odenwilusenz/LRK/Programmieren/workspace/wireless_led_bar/lrkmaster.py

import serial
import time

B1mask = 0b00000001
B2mask = 0b00000010
G1mask = 0b00000100
G2mask = 0b00001000
R1mask = 0b00000010
R2mask = 0b00000100

b_calibration = [x**2/600 for x in range(0,256)]
g_calibration = [x**2/400 for x in range(0,256)]
r_calibration = [x**2/255 for x in range(0,256)]

class LRKError(Exception):
  pass

class LRKmaster:
  def __init__(self, portname):
    self.portname = portname
    self.lastaddress = (231,231)
    self.lastcolour = (0,0,0,0,0,0)
    return

  def __enter__(self):
    self.ser = serial.Serial(self.portname, 115200, serial.EIGHTBITS, serial.PARITY_NONE, serial.STOPBITS_ONE, 2, False, False, None, False, None)
    time.sleep(2)
    self.ser.flushInput()
    self.ser.flushOutput()
    try:
      self.hello()
      self.flushFifos()
      self.setRetry(3,15)
      self.address(231,231)
      self.colour(0,0,0,0,0,0)
    except:
      self.ser.close()
      raise
    return self

  def __exit__(self, et,ev,tb):
    if (et == None and ev == None and tb == None):
      self.ser.write(b'q')
      self.ser.write(b'a231,231,231,231,231.')
      self.ser.write(b'b0,0,0,0,0,0,0,0,0,0,0,0,0,0.')
      self.ser.flushInput()
    self.ser.close()
    return

  def hello(self):
    self.ser.write(b'h')
    hello = str.strip(self.ser.readline().decode())
    if (hello != '1.1ok'):
      raise LRKError('device identification failed. device returned ', hello, ' instead of 1.1ok')
    return

  def status(self):
    self.ser.write(b's')
    return str.strip(self.ser.readline().decode())

  def readReg(self, reg):
    self.ser.write(b'r')
    self.ser.write(str(int(reg) % 256).encode())
    self.ser.write(b'.')
    return str.strip(self.ser.readline().decode())

  def setRetry(self, interval, count):
    self.ser.write(b'm')
    self.ser.write(str(int(interval) % 16).encode())
    self.ser.write(b',')
    self.ser.write(str(int(count) % 16).encode())
    self.ser.write(b'.')
    if (str.strip(self.ser.readline().decode()) != 'ok'):
      raise LRKError('setting retry count failed')
    return
    

  def flushFifos(self):
    self.ser.write(b'f')
    if (str.strip(self.ser.readline().decode()) != 'ok'):
      raise LRKError('flushing fifos failed')
    return

  def clearInterrupts(self):
    self.ser.write(b'q')
    if (str.strip(self.ser.readline().decode()) != 'ok'):
      raise LRKError('clearing interrupts failed')
    return

  def channel(self, chan):
    self.ser.write(b'c')
    self.ser.write(str(int(chan) % 256).encode())
    self.ser.write(b'.')
    if (str.strip(self.ser.readline().decode()) != 'ok'):
      raise LRKError('setting channel failed')
    return

  def address(self, row, place):
    rowstring = str(int(row) % 256)
    placestring = str(int(place) % 256)
    self.ser.write(b'a231,')
    self.ser.write(rowstring.encode())
    self.ser.write(b',')
    self.ser.write(placestring.encode())
    self.ser.write(b',231,231.')
    if (str.strip(self.ser.readline().decode()) != 'ok'):
      raise LRKError('setting send address failed')
    self.lastaddress = (row,place)
    return

  def colour(self, r1, g1, b1, r2, g2, b2, calibration=True):
    pl = pwmlist(r1, g1, b1, r2, g2, b2, calibration)
    self.ser.write(b'b')
    for v in pl[:-1]:
      self.ser.write(str(v).encode())
      self.ser.write(b',')
    self.ser.write(b'1.')
    if (str.strip(self.ser.readline().decode()) != 'ok'):
       raise LRKError('setting pwmlist buffer failed')
    self.lastcolour = (r1, g1, b1, r2, g2, b2)
    return

  def send(self):
    self.ser.write(b't')
    reply = str.strip(self.ser.readline().decode())
    if (reply != 'ok'):
       raise LRKError('sending failed with '+reply)
    return

  def do(self, row, place, r1, g1, b1, r2, g2, b2):
    if (self.lastaddress != (row, place)):
      self.address(row, place)
    if (self.lastcolour != (r1, g1, b1, r2, g2, b2)):
      self.colour(r1, g1, b1, r2, g2, b2)
    self.send()
    return


def pwmlist(r1, g1, b1, r2, g2, b2,calibration):
  pwmlistbg =[1,0,1,0,1,0,1,0,1] 
  pwmlistr = [1,0,1,0,1]
  if (calibration):
    b1c = b_calibration[b1]
    b2c = b_calibration[b2]
    g1c = g_calibration[g1]
    g2c = g_calibration[g2]
    r1c = r_calibration[r1]
    r2c = r_calibration[r2]
  else:
    b1c = b1
    b2c = b2
    g1c = g1
    g2c = g2
    r1c = r1
    r2c = r2
    
  basebg = [(int(b1c),B1mask),(int(b2c),B2mask),(int(g1c),G1mask),(int(g2c),G2mask)]
  baser = [(int(r1c),R1mask),(int(r2c),R2mask)]
  cropbg = filter(lambda a: a[0] != 0, basebg)
  cropr = filter(lambda a: a[0] != 0, baser)
  negbg = map(lambda a: (-a[0]%256,a[1]), cropbg)
  negr = map(lambda a: (-a[0]%256,a[1]), cropr)
  last = 0
  i = 0
  for a in sorted(negbg):
    if (a[0] == last):
      pwmlistbg[i*2-1] = pwmlistbg[i*2-1] | a[1]      
    else:
      pwmlistbg[i*2] = a[0]
      pwmlistbg[i*2+1] = a[1]
      last = a[0]
      i = i + 1
  last = 0
  i = 0
  for a in sorted(negr):
    if (a[0] == last):
      pwmlistr[i*2-1] = pwmlistr[i*2-1] | a[1]      
    else:
      pwmlistr[i*2] = a[0]
      pwmlistr[i*2+1] = a[1]
      last = a[0]
      i = i + 1
  return pwmlistbg+pwmlistr
