odenwilusenz/LRK/(commit log)

2016-02-05 Include PCB design files
    [LRK.kicad_pcb, LRK.sch, LRK15.kicad_pcb]
2016-02-05 Replace AP2210 with a generic regulator
    [LRK.sch]
2016-02-05 Include microcontroller and Arduino programs
